Kybernetika-SPSE/DMP_Machacek/PCB/IR_8_channel.kicad_pcb

## KiCad design PCB/IR_8_channel.kicad_pcb (2024-11-21)

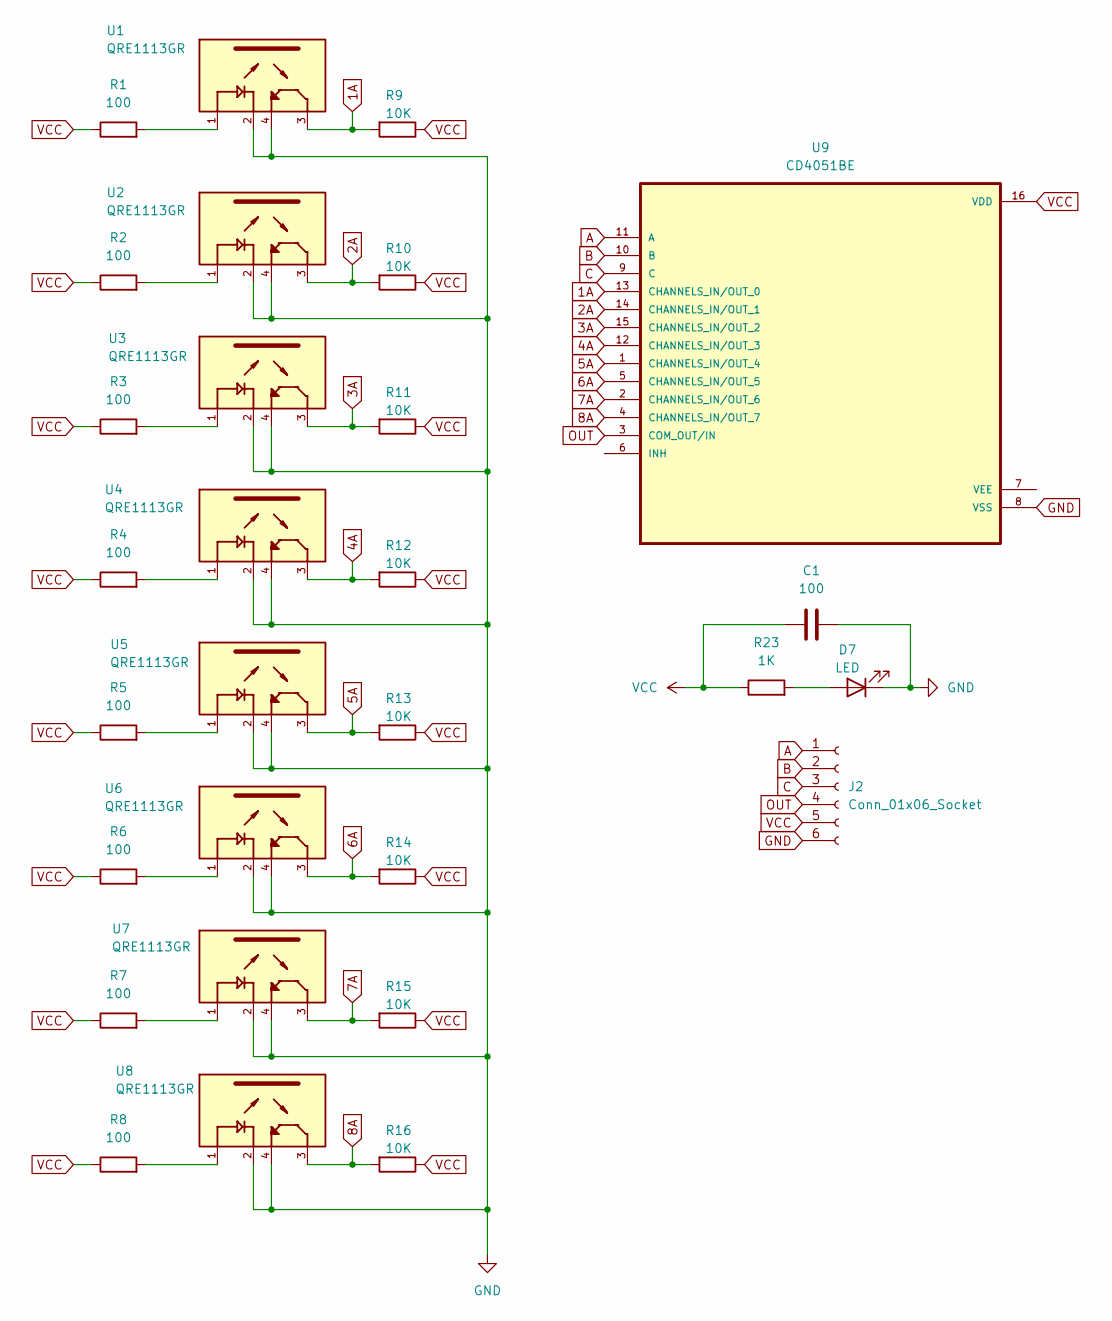
[picture p1: schematic IR_8_channel.kicad_sch]

Parts:
C1: 100; CP_Elec_3x5.3
D7: LED; D_0201_0603Metric
J2: Conn_01x06_Socket; JST_XH_S6B-XH-A_1x06_P2.50mm_Horizontal
R1, R2, R3, R4, R5, R6, R7, R8: 100; R_0201_0603Metric
R9, R10, R11, R12, R13, R14, R15, R16: 10K; R_0201_0603Metric
R23: 1K; R_0201_0603Metric
U1, U2, U3, U4, U5, U6, U7, U8: QRE1113GR; SOIC180P460X187-4N; PARTREV 5
U9: CD4051BE; DIP794W45P254L1969H508Q16

Connections:
1A: R9.2, U1.3, U9.13 (CHANNELS_IN/OUT_0)
2A: R10.2, U2.3, U9.14 (CHANNELS_IN/OUT_1)
3A: R11.2, U3.3, U9.15 (CHANNELS_IN/OUT_2)
4A: R12.2, U4.3, U9.12 (CHANNELS_IN/OUT_3)
5A: R13.2, U5.3, U9.1 (CHANNELS_IN/OUT_4)
6A: R14.2, U6.3, U9.5 (CHANNELS_IN/OUT_5)
7A: R15.2, U7.3, U9.2 (CHANNELS_IN/OUT_6)
8A: R16.2, U8.3, U9.4 (CHANNELS_IN/OUT_7)
A: J2.1, U9.11 (A)
B: J2.2, U9.10 (B)
C: J2.3, U9.9 (C)
GND: C1.2, D7.1 (K), J2.6, U1.2, U1.4, U2.2, U2.4, U3.2, U3.4, U4.2, U4.4, U5.2, U5.4, U6.2, U6.4, U7.2, U7.4, U8.2, U8.4, U9.8 (VSS)
unnamed: D7.2 (A), R23.2
unnamed: R1.2, U1.1
unnamed: R2.2, U2.1
unnamed: R3.2, U3.1
unnamed: R4.2, U4.1
unnamed: R5.2, U5.1
unnamed: R6.2, U6.1
unnamed: R7.2, U7.1
unnamed: R8.2, U8.1
OUT: J2.4, U9.3 (COM_OUT/IN)
VCC: C1.1, J2.5, R1.1, R2.1, R3.1, R4.1, R5.1, R6.1, R7.1, R8.1, R9.1, R10.1, R11.1, R12.1, R13.1, R14.1, R15.1, R16.1, R23.1, U9.16 (VDD)

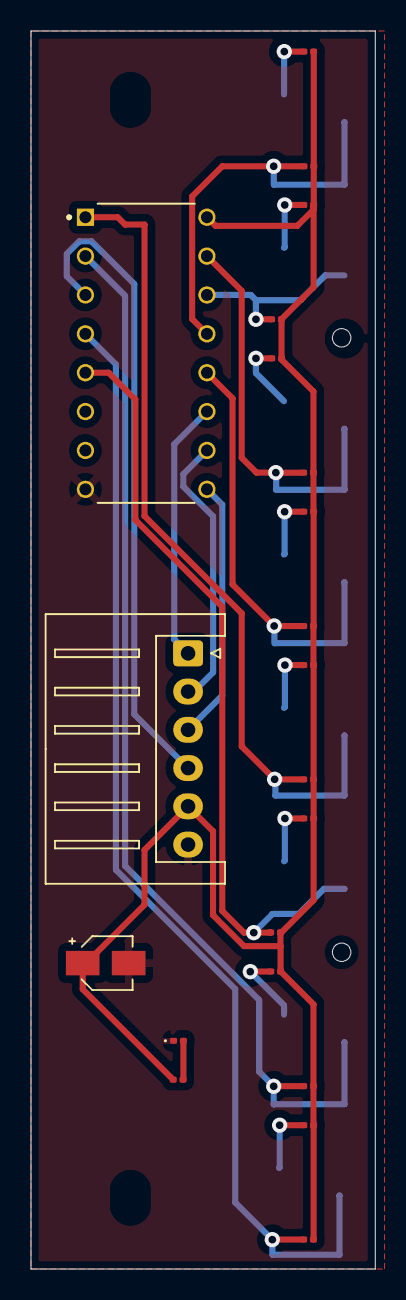
[picture p2: board IR_8_channel.kicad_pcb from above]

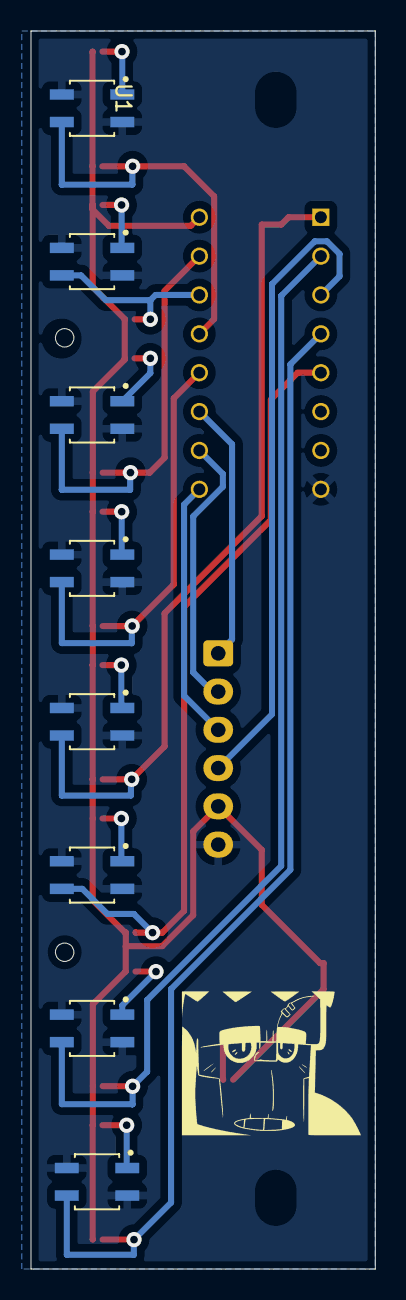
[picture p3: board IR_8_channel.kicad_pcb from below]

Board: 2 copper layers, 22.5 x 80.9 mm, 29 parts (8 on the bottom side), 23 nets.
